TrieuDanTran2102/WHEEL_BALANCING_CAR/z7303004034842_84c174503d8fb58b2cd90673eee8b55a.jpg

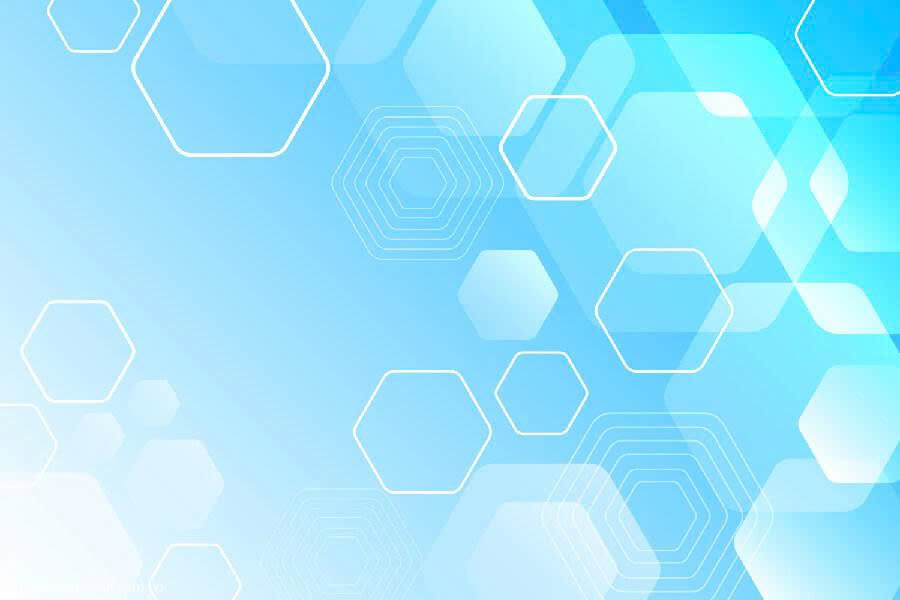
z7303004034842_84c174503d8fb58b2cd90673eee8b55a.jpg
