TrieuDanTran2102/WHEEL_BALANCING_CAR/web_page/car_background.png

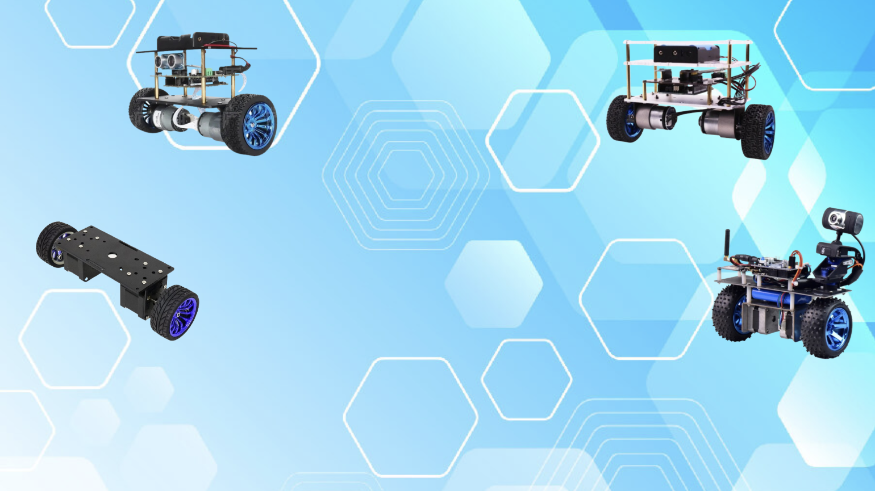
web_page/car_background.png
