TrieuDanTran2102/WHEEL_BALANCING_CAR/WHEEL_BALACING_CAR/Core/Src/main.c

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
/* Includes ------------------------------------------------------------------*/
#include "main.h"
#include "usb_device.h"

/* USER CODE BEGIN Includes */
#include <stdio.h>
#include <string.h>
#include <stdlib.h>
#include <math.h>
#include "usbd_cdc_if.h"
#include "mpu6050.h"
#include "pid.h"
#include "motor.h"
/* USER CODE END Includes */

I2C_HandleTypeDef hi2c1;

TIM_HandleTypeDef htim1;
TIM_HandleTypeDef htim2;
TIM_HandleTypeDef htim3;
TIM_HandleTypeDef htim4;
TIM_HandleTypeDef htim5;

UART_HandleTypeDef huart2;

/* USER CODE BEGIN PV */
MPU6050_t MPU6050;
Motor_TypeDef MT;
PID_TypeDef PID_Angle;

double Angle;
double Angle_Output;
double Angle_Setpoint = 0.5;

extern uint8_t check_global;

float Angle_kp = 18; //18
float Angle_ki = 122; //122
float Angle_kd = 0.32; //0.32

uint8_t Delay5msFlag = 0;
uint8_t Delay40msFlag = 0;

uint8_t sbBuffer[50];
uint8_t sbBufferLen = sizeof(sbBuffer);
uint8_t space[] = "\r\n";
uint8_t USB_ReceiveFlag = 0;
char *mPart, *dPart, *sPart;

uint8_t RxBuff[20];
uint8_t RxData;
uint8_t RxIndex;
uint8_t RxFlag = 0;
uint8_t PxBuff[20];

char buffer[50];
double sub = 0;
/* USER CODE END PV */

void SystemClock_Config(void);
static void MX_GPIO_Init(void);
static void MX_I2C1_Init(void);
static void MX_TIM1_Init(void);
static void MX_TIM2_Init(void);
static void MX_TIM3_Init(void);
static void MX_TIM5_Init(void);
static void MX_TIM4_Init(void);
static void MX_USART2_UART_Init(void);
/* USER CODE BEGIN 0 */
int _write(int file, char *ptr, int len) {
	while(CDC_Transmit_FS((uint8_t*) ptr, len) == USBD_BUSY);
    return len;
//    HAL_UART_Transmit(&huart2, (uint8_t *)ptr, len, HAL_MAX_DELAY);
//    return len;
}

void USB_CDC_RxHandler(uint8_t* Buf, uint32_t Len)
{
	memcpy(sbBuffer, Buf, Len);
	sbBuffer[Len] = '\0';
	sbBufferLen = Len;
	CDC_Transmit_FS(space, sizeof(space));

	USB_ReceiveFlag = 1;
}

void HAL_TIM_PeriodElapsedCallback(TIM_HandleTypeDef *htim)
{
	if (htim->Instance == TIM4)
	{
		Delay5msFlag = 1;
	}
	if (htim->Instance == TIM5)
	{
		Delay40msFlag = 1;
	}
}
//
//void UART2_SendFloat(float data)
//{
//    char buf[20];
//    int len = sprintf(buf, "%f\r\n", data);  // chuỗi có newline cho Serial Plotter
//    HAL_UART_Transmit(&huart2, (uint8_t*)buf, len, HAL_MAX_DELAY);
//}

void HAL_UART_RxCpltCallback(UART_HandleTypeDef *huart)
{
  /* Prevent unused argument(s) compilation warning */
  UNUSED(huart);
  if (huart->Instance == USART2)
  {
	  if (RxData != 13)
	  {
		  RxBuff[RxIndex++] = RxData;
	  }
	  else
	  {
		  RxBuff[RxIndex] = '\0';
		  RxIndex = 0;
		  RxFlag = 1;
	  }
	  HAL_UART_Receive_IT(&huart2, &RxData, 1);
  }
  /* NOTE: This function should not be modified, when the callback is needed,
           the HAL_UART_RxCpltCallback could be implemented in the user file
   */
}


/* USER CODE END 0 */

/**
  * @brief  The application entry point.
  * @retval int
  */
int main(void)
{

  /* MCU Configuration--------------------------------------------------------*/

  /* Reset of all peripherals, Initializes the Flash interface and the Systick. */
  HAL_Init();

  /* Configure the system clock */
  SystemClock_Config();

  /* Initialize all configured peripherals */
  MX_GPIO_Init();
  MX_USB_DEVICE_Init();
  MX_I2C1_Init();
  MX_TIM1_Init();
  MX_TIM2_Init();
  MX_TIM3_Init();
  MX_TIM5_Init();
  MX_TIM4_Init();
  MX_USART2_UART_Init();
  /* USER CODE BEGIN 2 */
  HAL_TIM_PWM_Start(&htim1, TIM_CHANNEL_1);
  HAL_TIM_PWM_Start(&htim2, TIM_CHANNEL_1);
  HAL_TIM_Encoder_Start(&htim3, TIM_CHANNEL_ALL);
  HAL_TIM_Base_Start_IT(&htim5);
  HAL_TIM_Base_Start_IT(&htim4);
//  HAL_UART_Receive_IT(&huart1, &rxByte, 1);

  mpu6050_init(&MPU6050, &Angle);
  PID_Init(&PID_Angle, &Angle, &Angle_Output, &Angle_Setpoint, Angle_kp, Angle_ki, Angle_kd, 5);

  setLimit(&PID_Angle, 50, -50, 100, -100);

  timer = HAL_GetTick();

  HAL_UART_Receive_IT(&huart2, &RxData, 1);
  /* USER CODE END 2 */

  /* Infinite loop */
  /* USER CODE BEGIN WHILE */
  while (1)
  {
//	  Xu ly giao tiep USB (Hercules, ESP32)
	  if (USB_ReceiveFlag)
	  {
	  	  char* OP = strtok((char*)sbBuffer, " ");
	  	  if (strcmp(OP, "T") == 0)
	  	  {
	  		  char* pPart = strtok(NULL, " ");
	  		  char* iPart = strtok(NULL, " ");
	  		  char* dPart = strtok(NULL, " ");

	  		  setTunings(&PID_Angle, atoff(pPart), atoff(iPart), atoff(dPart));

	  		  printf("Done!\r\n");
	  	  }
	  	  else if (strcmp(OP, "S") == 0)
	  	  {
	  		  printf("Kp: %f\r\n", fabs(PID_Angle.Kp));
	  		  printf("Ki: %f\r\n", fabs(PID_Angle.Ki/0.005));
	  		  printf("Kd: %f\r\n", fabs(PID_Angle.Kd*0.005));
	  		  printf("check_global: %d\r\n", check_global);
	  		  printf("Angle_Setpoint: %f\r\n", Angle_Setpoint);
	  		  printf("Angle: %f\r\n", Angle);
	  		  printf("Speed: %d\r\n", MT.per);
	  		  printf("Angle_Output: %f\r\n", Angle_Output);
	  	  }
	  	  else if (strcmp(OP, "M") == 0)
	  	  {
	  		  printf("Tuning: T <Kp> <Ki> <Kd>\r\n");
	  		  printf("Status: S\r\n");
	  	  }
	  	  else if (strcmp(OP, "A") == 0)
	  	  {
	  		  char* aPart = strtok(NULL, " ");
	  		  Angle_Setpoint = atof(aPart);
	  		  printf("Done!\r\n");
	  	  }
	  	  USB_ReceiveFlag = 0;
	  }

//	  if (RxFlag)
//	  	  {
//	  		  RxFlag = 0;
//	  		  HAL_UART_Transmit(&huart2, space, sizeof(space), HAL_MAX_DELAY);
//
//	  		  memcpy(PxBuff, RxBuff, sizeof(RxBuff));
//	  		  char* OP = strtok((char*)PxBuff, " ");
//	  		  if (strcmp(OP, "T") == 0)
//	  		  {
//	  	  		  char* pPart = strtok(NULL, " ");//Kp Part
//	  	  		  char* iPart = strtok(NULL, " ");//Ki Part
//	  	  		  char* dPart = strtok(NULL, " ");//Kd Part
//
//	  	  		  setTunings(&PID_Angle, atoff(pPart), atoff(iPart), atoff(dPart));
//	  //	  		  setTunings(&PID_Velocity1, atoff(pPart), atoff(iPart), atoff(dPart));
//	  	  		  printf("DONE!\r\n");
//	  		  }
//	  		  else if (strcmp(OP, "S") == 0)
//	  		  {
//	  	  		  printf("Kp: %f\r\n", fabs(PID_Angle.Kp));
//	  	  		  printf("Ki: %f\r\n", fabs(PID_Angle.Ki/0.01));
//	  	  		  printf("Kd: %f\r\n", fabs(PID_Angle.Kd*0.01));
//	  	  		  printf("Angle: %f\r\n", Angle);
//	  	  		  printf("Speed: %d\r\n", MT.per);
//	  	  		  printf("check_global: %d\r\n", check_global);
//	  		  }
//	  		  else if (strcmp(OP, "C") == 0)
//	  		  {
//	  			  char* mPart = strtok(NULL, " ");//Motor Part (M1, M2, ALL)
//	  			  char* dPart = strtok(NULL, " ");//Direct Part (F, R, S)
//	  			  char* sPart = strtok(NULL, " ");//Speed Part (0-100)
//
//	  			  Motor motor;
//	  			  Direction dir;
//	  			  uint16_t speed = atoi(sPart);
//
//	  			  if (strcmp(mPart, "M1") == 0) motor = M1;
//	  			  else if (strcmp(mPart, "M2") == 0) motor = M2;
//	  			  else if (strcmp(mPart, "ALL") == 0) motor = ALL;
//
//	  			  if (strcmp(dPart, "F") == 0) dir = F;
//	  			  else if (strcmp(mPart, "R") == 0) dir = R;
//	  			  else if (strcmp(mPart, "S") == 0) dir = S;
//
//	  			  Motor_Controller(motor, dir, speed);
//	  		  }
//	  	  }

	  	if (Delay5msFlag)
		{
	  		Delay5msFlag = 0;
	  		mpu6050_read_All(&MPU6050);
	  		computePID(&PID_Angle);
		}
		sprintf(buffer,"Angle: %f\r\n",Angle);
		CDC_Transmit_FS((uint8_t*)buffer, strlen(buffer));

	  	Motor_getPercent(&MT, Angle_Output);
	  	Motor_Controller(ALL, MT.dir, MT.per);

//	  	Motor_Controller(ALL, F, 100);
    /* USER CODE END WHILE */

    /* USER CODE BEGIN 3 */
  }

  /* USER CODE END 3 */
}

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
/* USER CODE BEGIN 4 */
//int _write(int file, char *ptr, int len)
//{
//    HAL_UART_Transmit(&huart2, (uint8_t *)ptr, len, HAL_MAX_DELAY);
//    return len;
//}
/* USER CODE END 4 */
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
