TrieuDanTran2102/WHEEL_BALANCING_CAR/WHEEL_BALACING_CAR/WHEEL_BALACING_CAR.ioc

Mcu.UserName=STM32F407VETx
PA11.Signal=USB_OTG_FS_DM
PA12.Signal=USB_OTG_FS_DP
PA2.Signal=USART2_TX
PA3.Signal=USART2_RX
PA5.GPIO_Label=ENB
PA5.Signal=S_TIM2_CH1_ETR
PA6.GPIO_Label=ENCODER1_A
PA6.Signal=S_TIM3_CH1
PA7.GPIO_Label=ENCODER1_B
PA7.Signal=S_TIM3_CH2
PB0.GPIO_Label=IN1
PB0.Signal=GPIO_Output
PB1.GPIO_Label=IN2
PB1.Signal=GPIO_Output
PB8.Signal=I2C1_SCL
PB9.Signal=I2C1_SDA
PC4.GPIO_Label=IN3
PC4.Signal=GPIO_Output
PC5.GPIO_Label=IN4
PC5.Signal=GPIO_Output
PE9.GPIO_Label=ENA
PE9.Signal=S_TIM1_CH1
PH0-OSC_IN.Signal=RCC_OSC_IN
PH1-OSC_OUT.Signal=RCC_OSC_OUT
