TrieuDanTran2102/WHEEL_BALANCING_CAR/WHEEL_BALACING_CAR/Core/Inc/main.h

#define ENB_Pin GPIO_PIN_5
#define ENB_GPIO_Port GPIOA
#define ENCODER1_A_Pin GPIO_PIN_6
#define ENCODER1_A_GPIO_Port GPIOA
#define ENCODER1_B_Pin GPIO_PIN_7
#define ENCODER1_B_GPIO_Port GPIOA
#define IN3_Pin GPIO_PIN_4
#define IN3_GPIO_Port GPIOC
#define IN4_Pin GPIO_PIN_5
#define IN4_GPIO_Port GPIOC
#define IN1_Pin GPIO_PIN_0
#define IN1_GPIO_Port GPIOB
#define IN2_Pin GPIO_PIN_1
#define IN2_GPIO_Port GPIOB
#define ENA_Pin GPIO_PIN_9
#define ENA_GPIO_Port GPIOE
