TrieuDanTran2102/WHEEL_BALANCING_CAR/(commit log)

2025-11-26 Create Wheel balancing car 11/26/2025
    [WHEEL_BALACING_CAR Debug.cfg]
2025-11-26 Add README for wheel balancing car project
    Added detailed project description, features, and hardware components for the wheel balancing car using STM32F407.
2025-12-05 change 6/12
    fixed mpu6050 i2c
    error in workspace of mpu6050_readALL
    change pid , change motor
    [main.c, motor.c, motor.h, mpu6050.c, mpu6050.h, pid.c, pid.h]
2026-02-27 Revise README for Two-Wheel Self-Balancing Robot
    Updated project title and expanded introduction. Added system architecture, hardware components, control algorithm, and performance details.
2026-02-27 Update university name and translate wiring diagram
