TrieuDanTran2102/WHEEL_BALANCING_CAR/(notices)

Notices in the files:
WHEEL_BALACING_CAR/Core/Inc/main.h:
Copyright (c) 2025 STMicroelectronics.
All rights reserved.
This software is licensed under terms that can be found in the LICENSE file
